Sleeeee/dvh/docs/labs/01_uart/walkthrough.md

# UART lab walkthrough

## Overview

This is a complete walkthrough of the UART lab, that is meant to guide you through every step of the way. You can read through this document to perform the lab, but for educational purposes, it is strongly suggested to use the [instructions](./instructions.md) as a main roadmap, and come back here whenever you feel stuck or need a sanity check.

> By this point, I assume that you have read through the instructions and understood the goal of this lab.

## Walkthrough

### Set up

Before starting the lab, you will need to have a functional [Debugprobe](../../tools/debugprobe.md). If you already performed the [SWD lab](../00_swd), you should already have one and be ready to get started.

We will have to connect the DVH board's UART interface with the corresponding Raspberry Pi Pico to allow them to communicate accordingly :

<div align="center">

| DVH | Pico |
|---|---|
| UART_RX | GP4  |
| UART_TX | GP5  |
| GND | GND  |

</div>

You may need to take a look at the pinout for both the DVH board and the [Raspberry Pi Pico](https://www.raspberrypi.com/documentation/microcontrollers/pico-series.html). As per UART standards, a circuit sends data through its `TX` pin, which is received by the other circuit on its `RX` pin.

<p align="center">
  UART wires
</p>

> Please note that this picture has been shot on the PCB version 0.1 which does not have the dedicated lab selection pins on board.

### Initial access

In order to establish a serial communication over UART, we will start by installing `minicom` :

```bash
sudo apt install minicom
```

> Feel free to choose any other alternative such as PuTTY for example.

You can now power on the Pico and the DVH board, then open the serial port using `minicom` :

```bash
minicom -b 115200 -o -D /dev/ttyACM0
```

Once inside the `minicom` interface, press `[ENTER]` to start receiving the UART shell prompt, as well as the first flag !

<p align="center">
  UART minicom
</p>

> The Raspberry Pi Pico is usually listed as `ttyACM0`, but you can make sure of it by running `ls /dev/tty*`.

### User escalation

By playing around in the terminal, we can see that this looks like a standard shell, maybe even bash ? We can type common commands, such as `ls`, `pwd`, `whoami` to verify if it is truly a Linux shell :

<p align="center">
  UART hello
</p>

Unlike we expected, we are not in a traditional shell environment. The system tells us that the `help` command does exist, let's run that :

<p align="center">
  UART help anonymous
</p>

This looks promising, we have access to built-in commands to log in and list existing users ! Let's see what we can find there :

<p align="center">
  UART list users
</p>

We successfully learned that there are two users on the system, `root` and `monitoring_svc`. However, we cannot directly log in as the root user, so we will have to pivot to `monitoring_svc` first. Unfortunately, it is guarded by a password, and it does not seem like any of the available commands can help us here.

If you are familiar with network equipments and IOT devices, you might remember they regularly use logging over serial connections, to print debug information for example. What we could do here, is to keep listening on our `minicom` session, and reset the power on the DVH board by unplugging it then plugging it back on. Interesting logs will start to appear :

<p align="center">
  UART boot logs
</p>

If we scroll all the way up and take a close look, we will observe that some credentials have actually been leaked ! We can now safely log in as the `monitoring_svc` user and obtain the second flag :

<p align="center">
  UART login
</p>

### Root escalation

We have now gained user privileges, which means we probably have access to new commands now ! Let's type `help` to verify that :

<p align="center">
  UART help user
</p>

We now have access to the `root` command which is noticeably guarded by a password :

<p align="center">
  UART root attempt
</p>

We can also observe that the `user_db` command was unlocked. By reading its usage, it seems pretty interesting to dump the database's contents :

<p align="center">
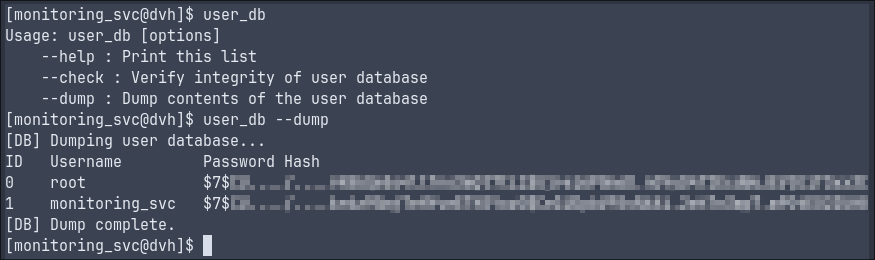
[picture p26: docs/images/uart_database_dump.png]
UART database dump
  
</p>

Unfortunately, we were not able to retrieve plain passwords, but we managed to get the next best thing, which is a password hash for the root user !

> In case you are unfamiliar with the concept, a hash is a one-way encryption method that is commonly used for password authentication. Since a hash can be computed from the original password, you only need to store the hash to verify that it matches the given password's hash.

By inspecting the hash format, we can see it is formatted like a [Linux password](https://man7.org/linux/man-pages/man3/crypt.3.html), which typically looks like this :

```bash
$id$salt$hashed
```

From there, we can identify the hashing function corresponding to ID 7. According to `libxcrypt`, the modern Linux hashing library ([source](https://github.com/besser82/libxcrypt/blob/develop/lib/hashes.conf)), we find that this value corresponds to `scrypt`.

Unfortunately, unlike some obsolete hashing functions like MD5, `scrypt` is considered safe and cannot be broken. However, even if we cannot reverse the hash, nothing is preventing us from brute-forcing it, by computing the hash for common passwords and seeing if any of them matches ! To help us with that, we will swap over to our Linux machine and install John The Ripper, a handy password cracking tool :

```bash
sudo apt update
sudo apt install john
```

John expects hashes to be inside a file, so we can paste our hash into a new `hash.txt` file (you will need to escape the `$` signs by placing a `\` before each of them). We also know the hashing function is `scrypt`. The only thing that is left is to find a wordlist, containing common passwords that will be tested against the hash. The one we will use is one of the most famous wordlists, which comes from a huge data breach from [RockYou](https://github.com/zacheller/rockyou) :

```bash
wget https://raw.githubusercontent.com/zacheller/rockyou/master/rockyou.txt.tar.gz
tar -xzvf rockyou.txt.tar.gz
```

> If you are using a Kali Linux machine, that wordlist is already stored as `/usr/share/wordlists/rockyou.txt`

Now, we can simply pass the hash, the hashing function, and the wordlist to John, and wait for it to return the password :

<p align="center">
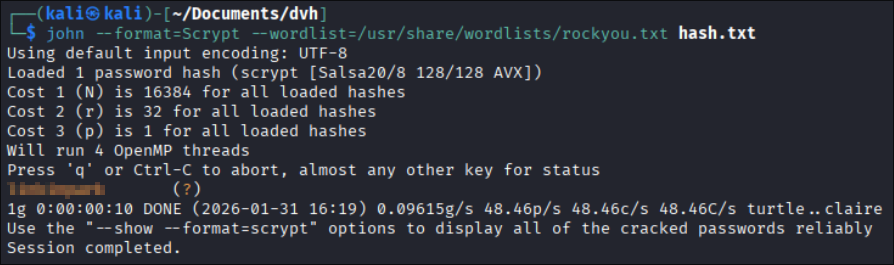
[picture p27: docs/images/uart_john_output.png]
UART John Output
  
</p>

The hash has been successfully brute-forced, and the string in orange is our plaintext password. Let's use that to authenticate as the root user :

<p align="center">
  UART root login
</p>

Congratulations, you have found all flags and successfully completed this lab !
