Sleeeee/dvh/docs/images/logicanalyzer_pulseview_channel.png

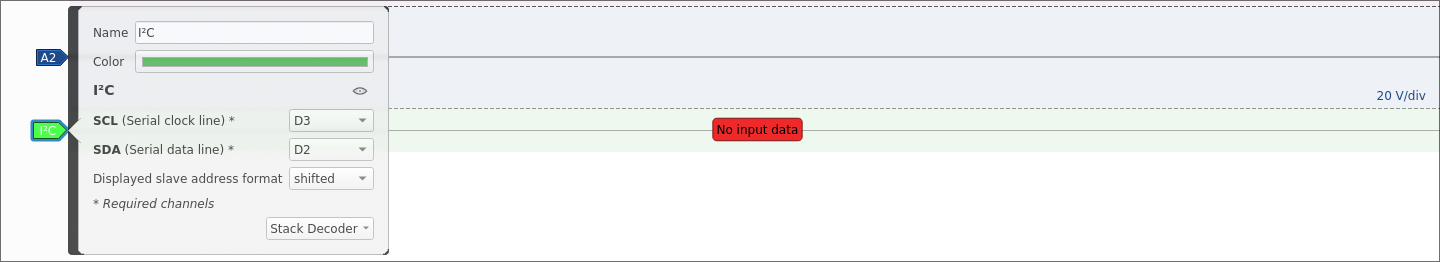
docs/images/logicanalyzer_pulseview_channel.png
