Sleeeee/dvh/docs/images/logicanalyzer_pulseview_decoder.png

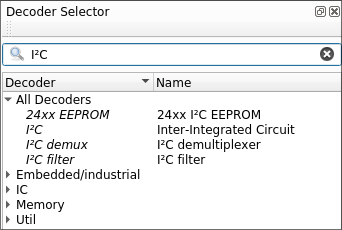
docs/images/logicanalyzer_pulseview_decoder.png
