Sleeeee/dvh/hardware/v1/kicad/v1.kicad_pcb

## KiCad design hardware/v1/kicad/v1.kicad_pcb (2026-05-03)

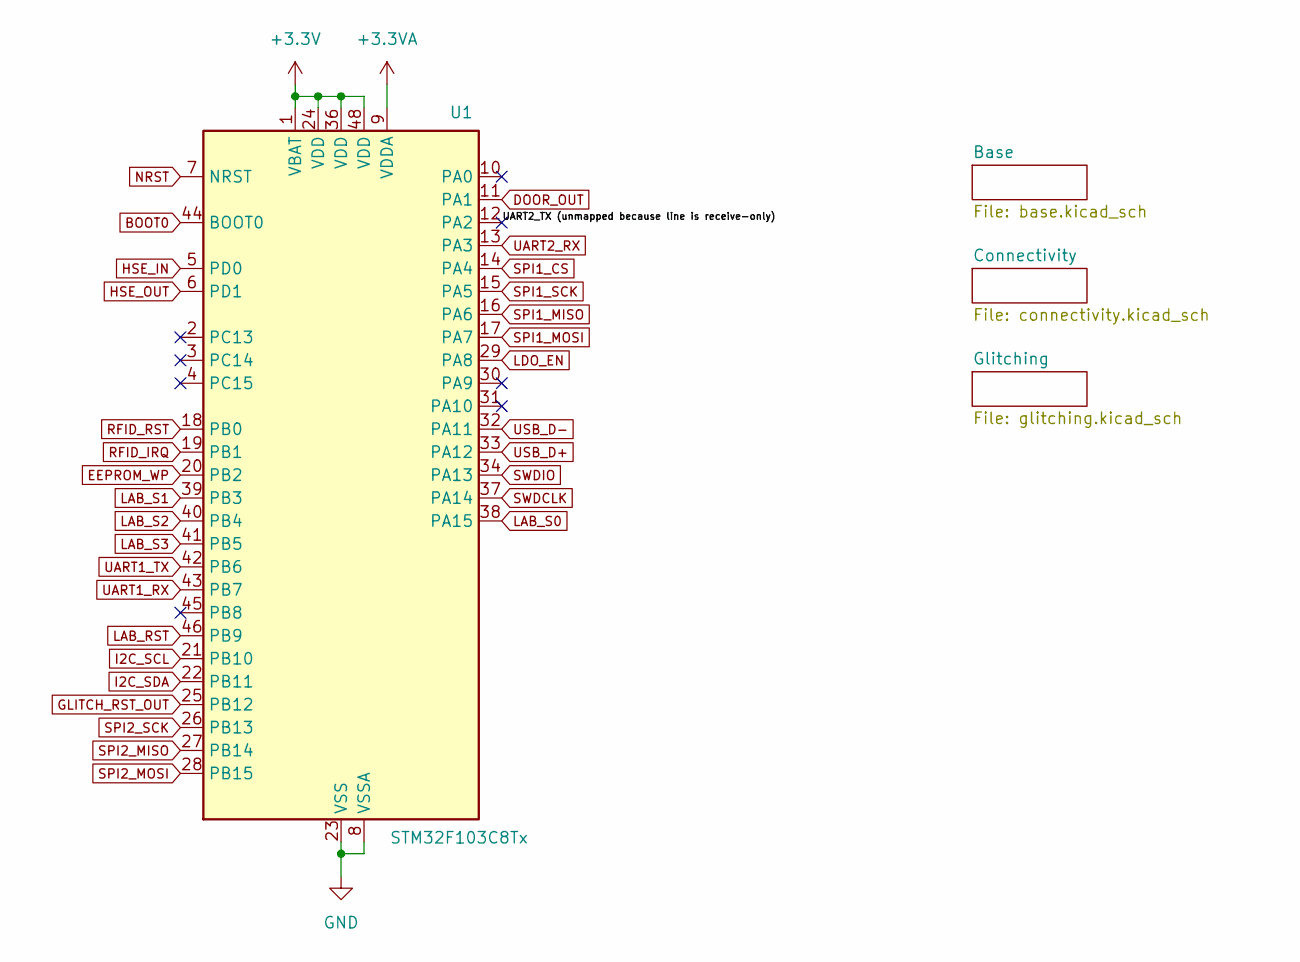
[picture p33: schematic v1.kicad_sch]

Parts:
U1: STM32F103C8Tx; LQFP-48_7x7mm_P0.5mm

Connections:
+3.3V: U1.1 (VBAT), U1.24 (VDD), U1.36 (VDD), U1.48 (VDD); also elsewhere on the board
+3.3VA: U1.9 (VDDA); also elsewhere on the board
/UART2_TX (unmapped because line is receive-only): U1.12 (PA2)
BOOT0: U1.44 (BOOT0); also elsewhere on the board
DOOR_OUT: U1.11 (PA1); also elsewhere on the board
EEPROM_WP: U1.20 (PB2); also elsewhere on the board
GLITCH_RST_OUT: U1.25 (PB12); also elsewhere on the board
GND: U1.8 (VSSA), U1.23 (VSS), U1.35 (VSS), U1.47 (VSS); also elsewhere on the board
HSE_IN: U1.5 (PD0); also elsewhere on the board
HSE_OUT: U1.6 (PD1); also elsewhere on the board
I2C_SCL: U1.21 (PB10); also elsewhere on the board
I2C_SDA: U1.22 (PB11); also elsewhere on the board
LAB_RST: U1.46 (PB9); also elsewhere on the board
LAB_S0: U1.38 (PA15); also elsewhere on the board
LAB_S1: U1.39 (PB3); also elsewhere on the board
LAB_S2: U1.40 (PB4); also elsewhere on the board
LAB_S3: U1.41 (PB5); also elsewhere on the board
LDO_EN: U1.29 (PA8); also elsewhere on the board
NRST: U1.7 (NRST); also elsewhere on the board
RFID_IRQ: U1.19 (PB1); also elsewhere on the board
RFID_RST: U1.18 (PB0); also elsewhere on the board
SPI1_CS: U1.14 (PA4); also elsewhere on the board
SPI1_MISO: U1.16 (PA6); also elsewhere on the board
SPI1_MOSI: U1.17 (PA7); also elsewhere on the board
SPI1_SCK: U1.15 (PA5); also elsewhere on the board
SPI2_MISO: U1.27 (PB14); also elsewhere on the board
SPI2_MOSI: U1.28 (PB15); also elsewhere on the board
SPI2_SCK: U1.26 (PB13); also elsewhere on the board
SWDCLK: U1.37 (PA14); also elsewhere on the board
SWDIO: U1.34 (PA13); also elsewhere on the board
UART1_RX: U1.43 (PB7); also elsewhere on the board
UART1_TX: U1.42 (PB6); also elsewhere on the board
UART2_RX: U1.13 (PA3); also elsewhere on the board
USB_D+: U1.33 (PA12); also elsewhere on the board
USB_D-: U1.32 (PA11); also elsewhere on the board

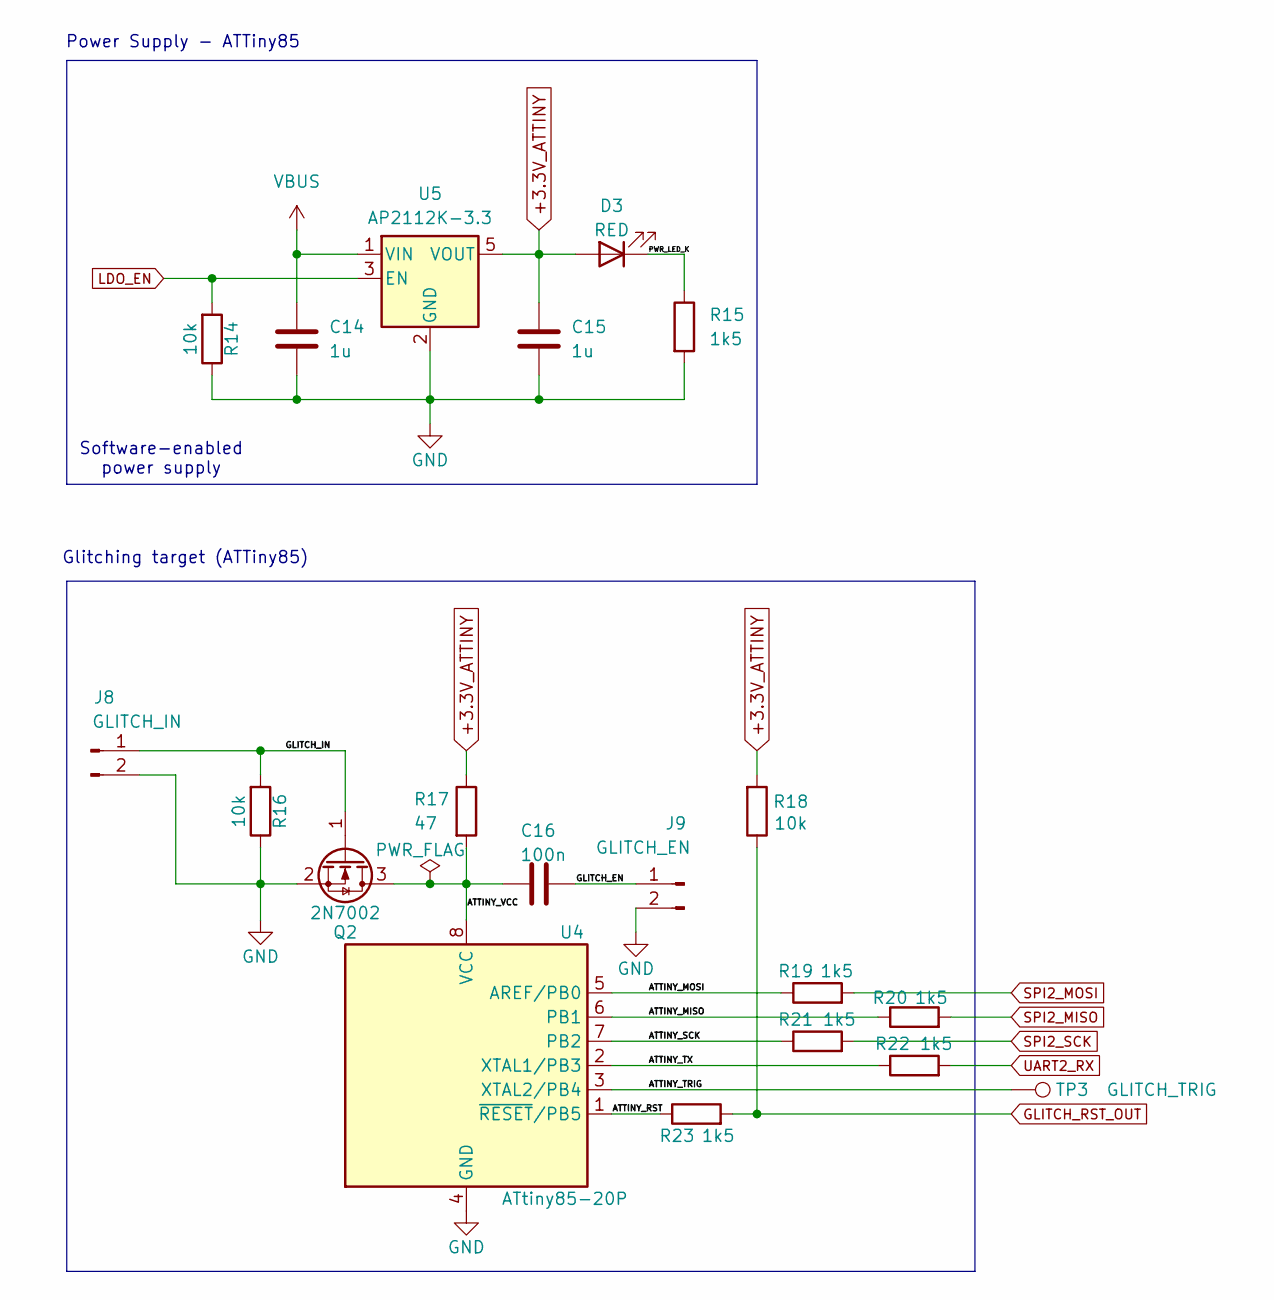
[picture p34: schematic glitching.kicad_sch]

Parts:
C14, C15: 1u; C_0805_2012Metric
C16: 100n; C_0402_1005Metric
D3: RED; LED_0603_1608Metric
J8: GLITCH_IN; PinHeader_1x02_P2.54mm_Vertical
J9: GLITCH_EN; PinHeader_1x02_P2.54mm_Vertical
Q2: 2N7002; SOT-23
R14, R16, R18: 10k; R_0402_1005Metric
R15, R19, R20, R21, R22, R23: 1k5; R_0402_1005Metric
R17: 47; R_1206_3216Metric
TP3: GLITCH_TRIG; TestPoint_THTPad_D2.0mm_Drill1.0mm
U4: ATtiny85-20P; DIP-8_W7.62mm
U5: AP2112K-3.3; SOT-23-5

Connections:
+3.3V_ATTINY: C15.1, D3.2 (A), R17.1, R18.2, U5.5 (VOUT)
/Glitching/ATTINY_MISO: R20.1, U4.6 (PB1)
/Glitching/ATTINY_MOSI: R19.1, U4.5 (AREF/PB0)
/Glitching/ATTINY_RST: R23.1, U4.1 (~RESET/PB5)
/Glitching/ATTINY_SCK: R21.1, U4.7 (PB2)
/Glitching/ATTINY_TRIG: TP3.1, U4.3 (XTAL2/PB4)
/Glitching/ATTINY_TX: R22.1, U4.2 (XTAL1/PB3)
/Glitching/ATTINY_VCC: C16.2, Q2.3 (D), R17.2, U4.8 (VCC)
/Glitching/GLITCH_EN: C16.1, J9.1
/Glitching/GLITCH_IN: J8.1, Q2.1 (G), R16.2
/Glitching/PWR_LED_K: D3.1 (K), R15.1
GLITCH_RST_OUT: R18.1, R23.2; also elsewhere on the board
GND: C14.2, C15.2, J8.2, J9.2, Q2.2 (S), R14.1, R15.2, R16.1, U4.4 (GND), U5.2 (GND); also elsewhere on the board
LDO_EN: R14.2, U5.3 (EN); also elsewhere on the board
SPI2_MISO: R20.2; also elsewhere on the board
SPI2_MOSI: R19.2; also elsewhere on the board
SPI2_SCK: R21.2; also elsewhere on the board
UART2_RX: R22.2; also elsewhere on the board
VBUS: C14.1, U5.1 (VIN); also elsewhere on the board

Notes on the sheet:
Power Supply - ATTiny85
Glitching target (ATTiny85)
Software-enabled power supply

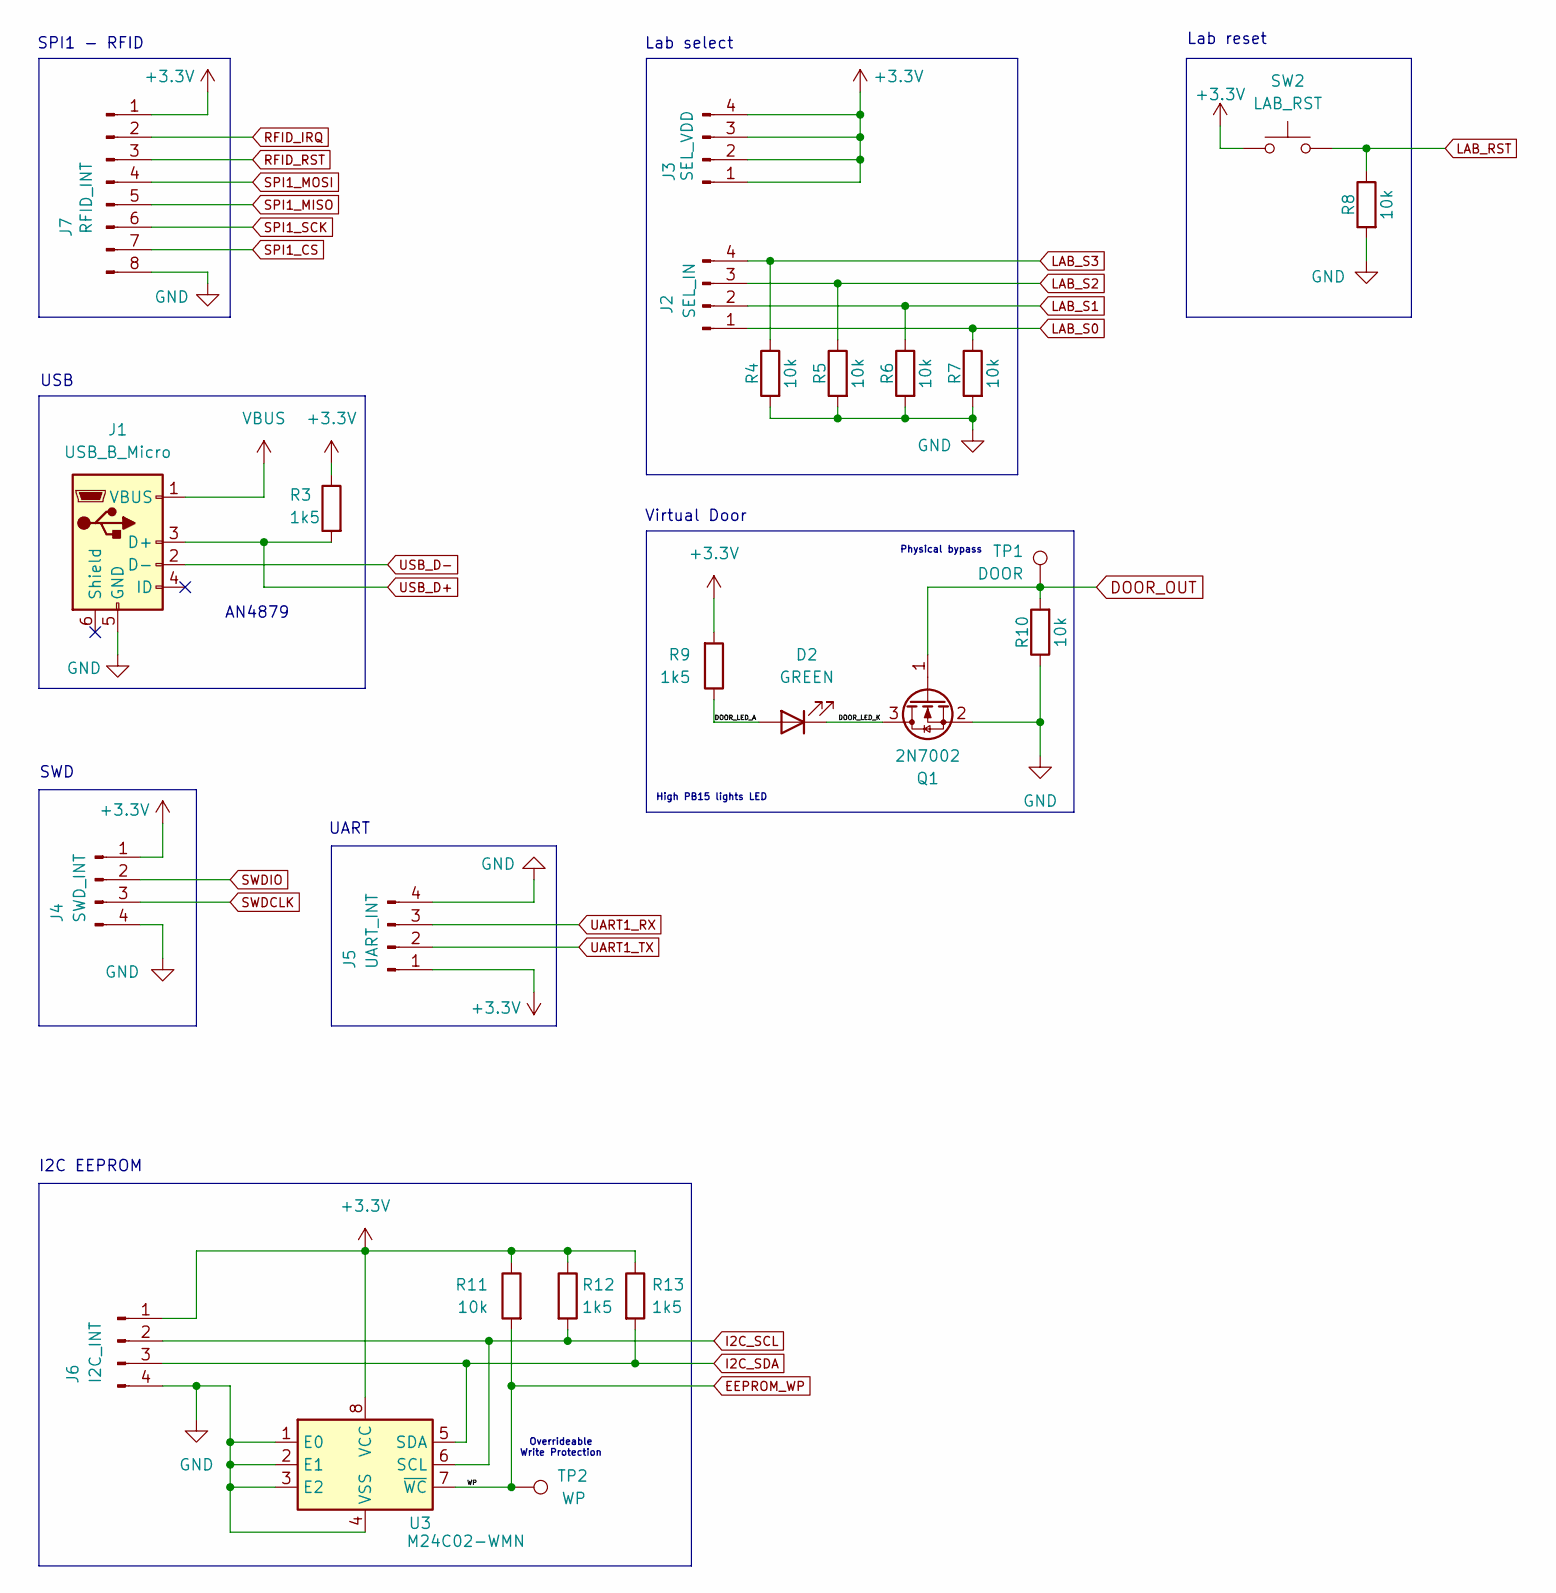
[picture p35: schematic connectivity.kicad_sch]

Parts:
D2: GREEN; LED_0603_1608Metric
J1: USB_B_Micro; USB_Micro-B_Amphenol_10118194-0001LF_Horizontal
J2: SEL_IN; PinHeader_1x04_P2.54mm_Vertical
J3: SEL_VDD; PinHeader_1x04_P2.54mm_Vertical
J4: SWD_INT; PinHeader_1x04_P2.54mm_Vertical
J5: UART_INT; PinHeader_1x04_P2.54mm_Vertical
J6: I2C_INT; PinHeader_1x04_P2.54mm_Vertical
J7: RFID_INT; PinHeader_1x08_P2.54mm_Vertical
Q1: 2N7002; SOT-23
R3, R9, R12, R13: 1k5; R_0402_1005Metric
R4, R5, R6, R7, R8, R10, R11: 10k; R_0402_1005Metric
SW2: LAB_RST; SW_Push_1TS009xxxx-xxxx-xxxx_6x6x5mm
TP1: DOOR; TestPoint_THTPad_D2.0mm_Drill1.0mm
TP2: WP; TestPoint_THTPad_D2.0mm_Drill1.0mm
U3: M24C02-WMN; SOIC-8_3.9x4.9mm_P1.27mm

Connections:
+3.3V: J3.1, J3.2, J3.3, J3.4, J4.1, J5.1, J6.1, J7.1, R3.1, R9.2, R11.1, R12.1, R13.1, SW2.1, U3.8 (VCC); also elsewhere on the board
/Connectivity/DOOR_LED_A: D2.2 (A), R9.1
/Connectivity/DOOR_LED_K: D2.1 (K), Q1.3 (D)
DOOR_OUT: Q1.1 (G), R10.2, TP1.1; also elsewhere on the board
EEPROM_WP: R11.2, TP2.1, U3.7 (~WC); also elsewhere on the board
GND: J1.5 (GND), J4.4, J5.4, J6.4, J7.8, Q1.2 (S), R4.2, R5.2, R6.2, R7.2, R8.2, R10.1, U3.1 (E0), U3.2 (E1), U3.3 (E2), U3.4 (VSS); also elsewhere on the board
I2C_SCL: J6.2, R12.2, U3.6 (SCL); also elsewhere on the board
I2C_SDA: J6.3, R13.2, U3.5 (SDA); also elsewhere on the board
LAB_RST: R8.1, SW2.2; also elsewhere on the board
LAB_S0: J2.1, R7.1; also elsewhere on the board
LAB_S1: J2.2, R6.1; also elsewhere on the board
LAB_S2: J2.3, R5.1; also elsewhere on the board
LAB_S3: J2.4, R4.1; also elsewhere on the board
RFID_IRQ: J7.2; also elsewhere on the board
RFID_RST: J7.3; also elsewhere on the board
SPI1_CS: J7.7; also elsewhere on the board
SPI1_MISO: J7.5; also elsewhere on the board
SPI1_MOSI: J7.4; also elsewhere on the board
SPI1_SCK: J7.6; also elsewhere on the board
SWDCLK: J4.3; also elsewhere on the board
SWDIO: J4.2; also elsewhere on the board
UART1_RX: J5.3; also elsewhere on the board
UART1_TX: J5.2; also elsewhere on the board
USB_D+: J1.3 (D+), R3.2; also elsewhere on the board
USB_D-: J1.2 (D-); also elsewhere on the board
VBUS: J1.1 (VBUS); also elsewhere on the board

Notes on the sheet:
High PB15 lights LED
SPI1 - RFID
USB
Physical bypass
I2C EEPROM
Lab reset
AN4879
UART
SWD
Overrideable Write Protection
Lab select
Virtual Door

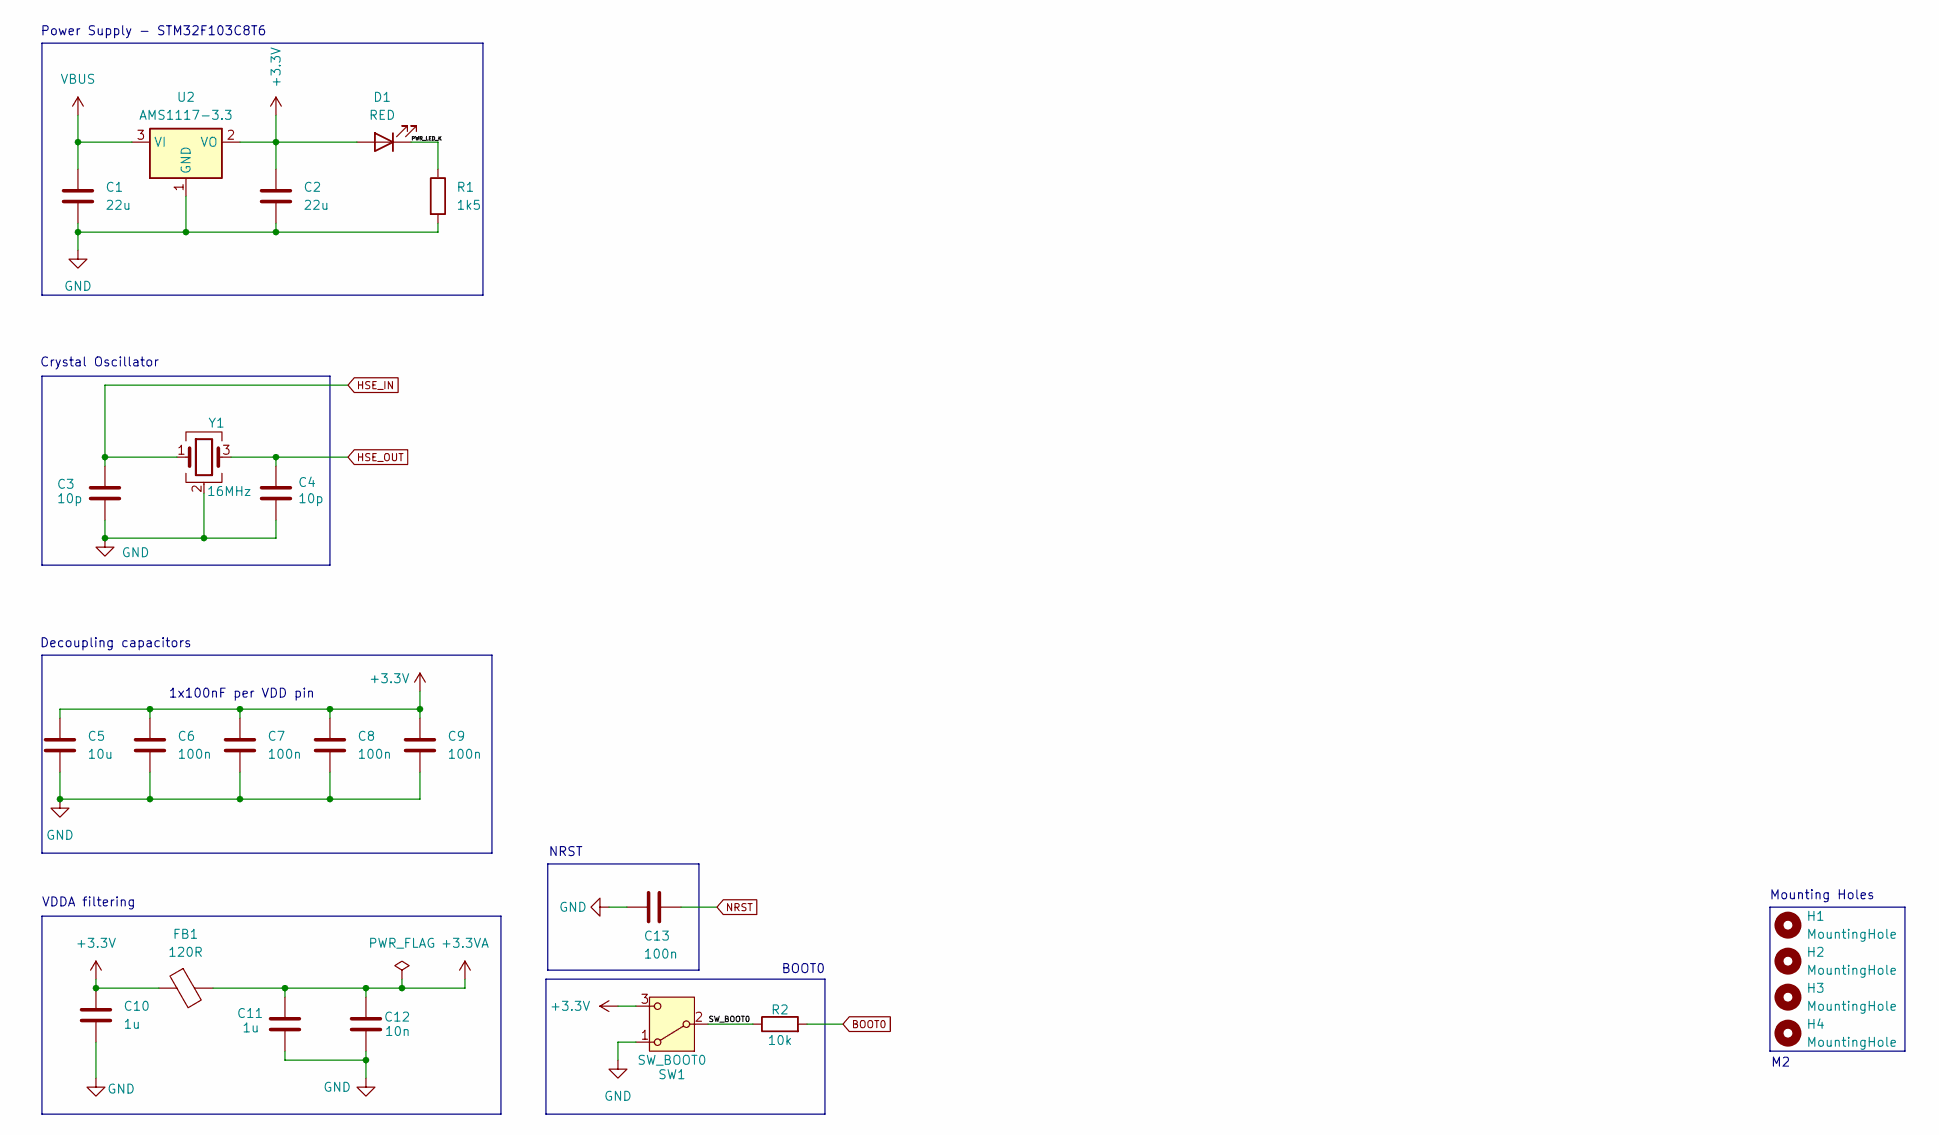
[picture p36: schematic base.kicad_sch]

Parts:
C1, C2: 22u; C_0805_2012Metric
C3, C4: 10p; C_0402_1005Metric
C5: 10u; C_0603_1608Metric
C6, C7, C8, C9, C13: 100n; C_0402_1005Metric
C10, C11: 1u; C_0402_1005Metric
C12: 10n; C_0402_1005Metric
D1: RED; LED_0603_1608Metric
FB1: 120R; L_0603_1608Metric
H1, H2, H3, H4: MountingHole; MountingHole_2.2mm_M2
R1: 1k5; R_0402_1005Metric
R2: 10k; R_0402_1005Metric
SW1: SW_BOOT0; SW_SPDT_CK_JS102011SAQN
U2: AMS1117-3.3; SOT-223-3_TabPin2
Y1: 16MHz; Crystal_SMD_3225-4Pin_3.2x2.5mm

Connections:
+3.3V: C2.1, C5.1, C6.1, C7.1, C8.1, C9.1, C10.1, D1.2 (A), FB1.1, SW1.3 (C), U2.2 (VO); also elsewhere on the board
+3.3VA: C11.1, C12.1, FB1.2; also elsewhere on the board
/Base/PWR_LED_K: D1.1 (K), R1.1
/Base/SW_BOOT0: R2.1, SW1.2 (B)
BOOT0: R2.2; also elsewhere on the board
GND: C1.2, C2.2, C3.2, C4.2, C5.2, C6.2, C7.2, C8.2, C9.2, C10.2, C11.2, C12.2, C13.2, R1.2, SW1.1 (A), U2.1 (GND), Y1.2 (G), Y1.4 (G); also elsewhere on the board
HSE_IN: C3.1, Y1.1; also elsewhere on the board
HSE_OUT: C4.1, Y1.3; also elsewhere on the board
NRST: C13.1; also elsewhere on the board
VBUS: C1.1, U2.3 (VI); also elsewhere on the board

Notes on the sheet:
Decoupling capacitors
NRST
VDDA filtering
Power Supply - STM32F103C8T6
Mounting Holes
Crystal Oscillator
BOOT0
1x100nF per VDD pin

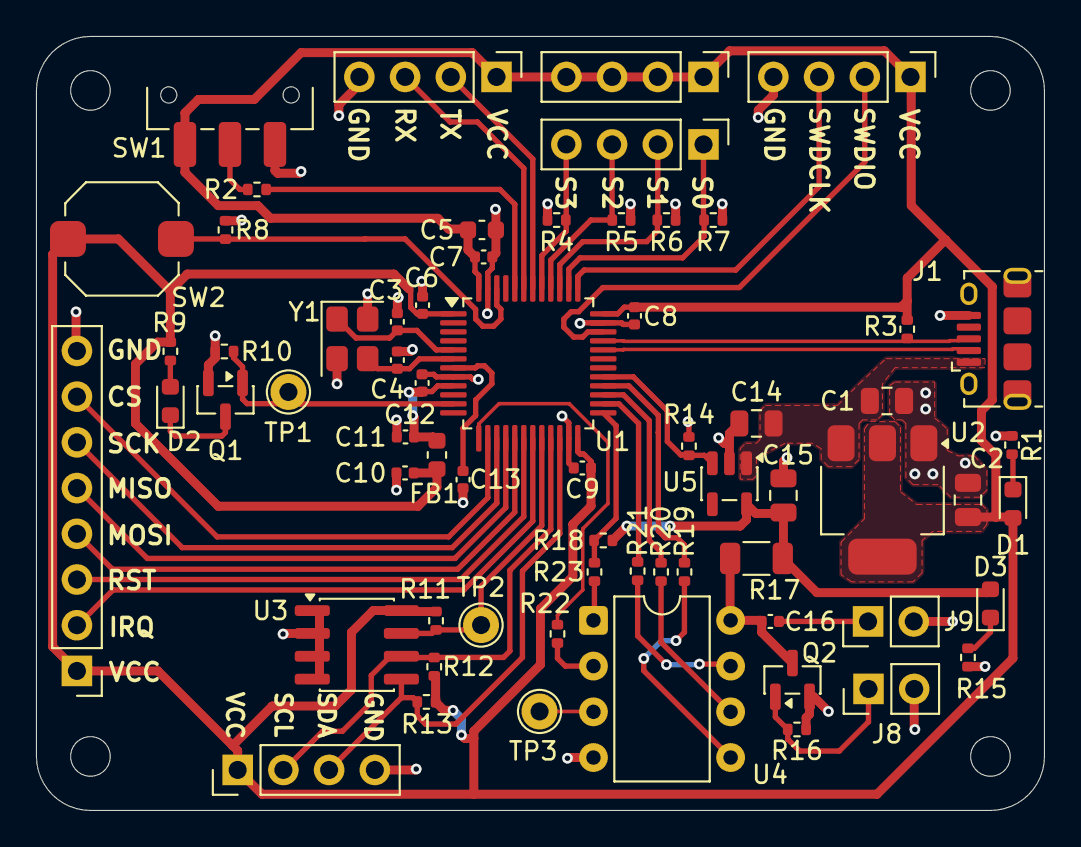
[picture p37: board v1.kicad_pcb from above]

Board: 2 copper layers, 56.0 x 43.0 mm, 69 parts (0 on the bottom side), 50 nets.
