Sleeeee/dvh/hardware/v0/kicad/dvh.kicad_pcb

## KiCad design hardware/v0/kicad/dvh.kicad_pcb (2025-11-27, an earlier design)

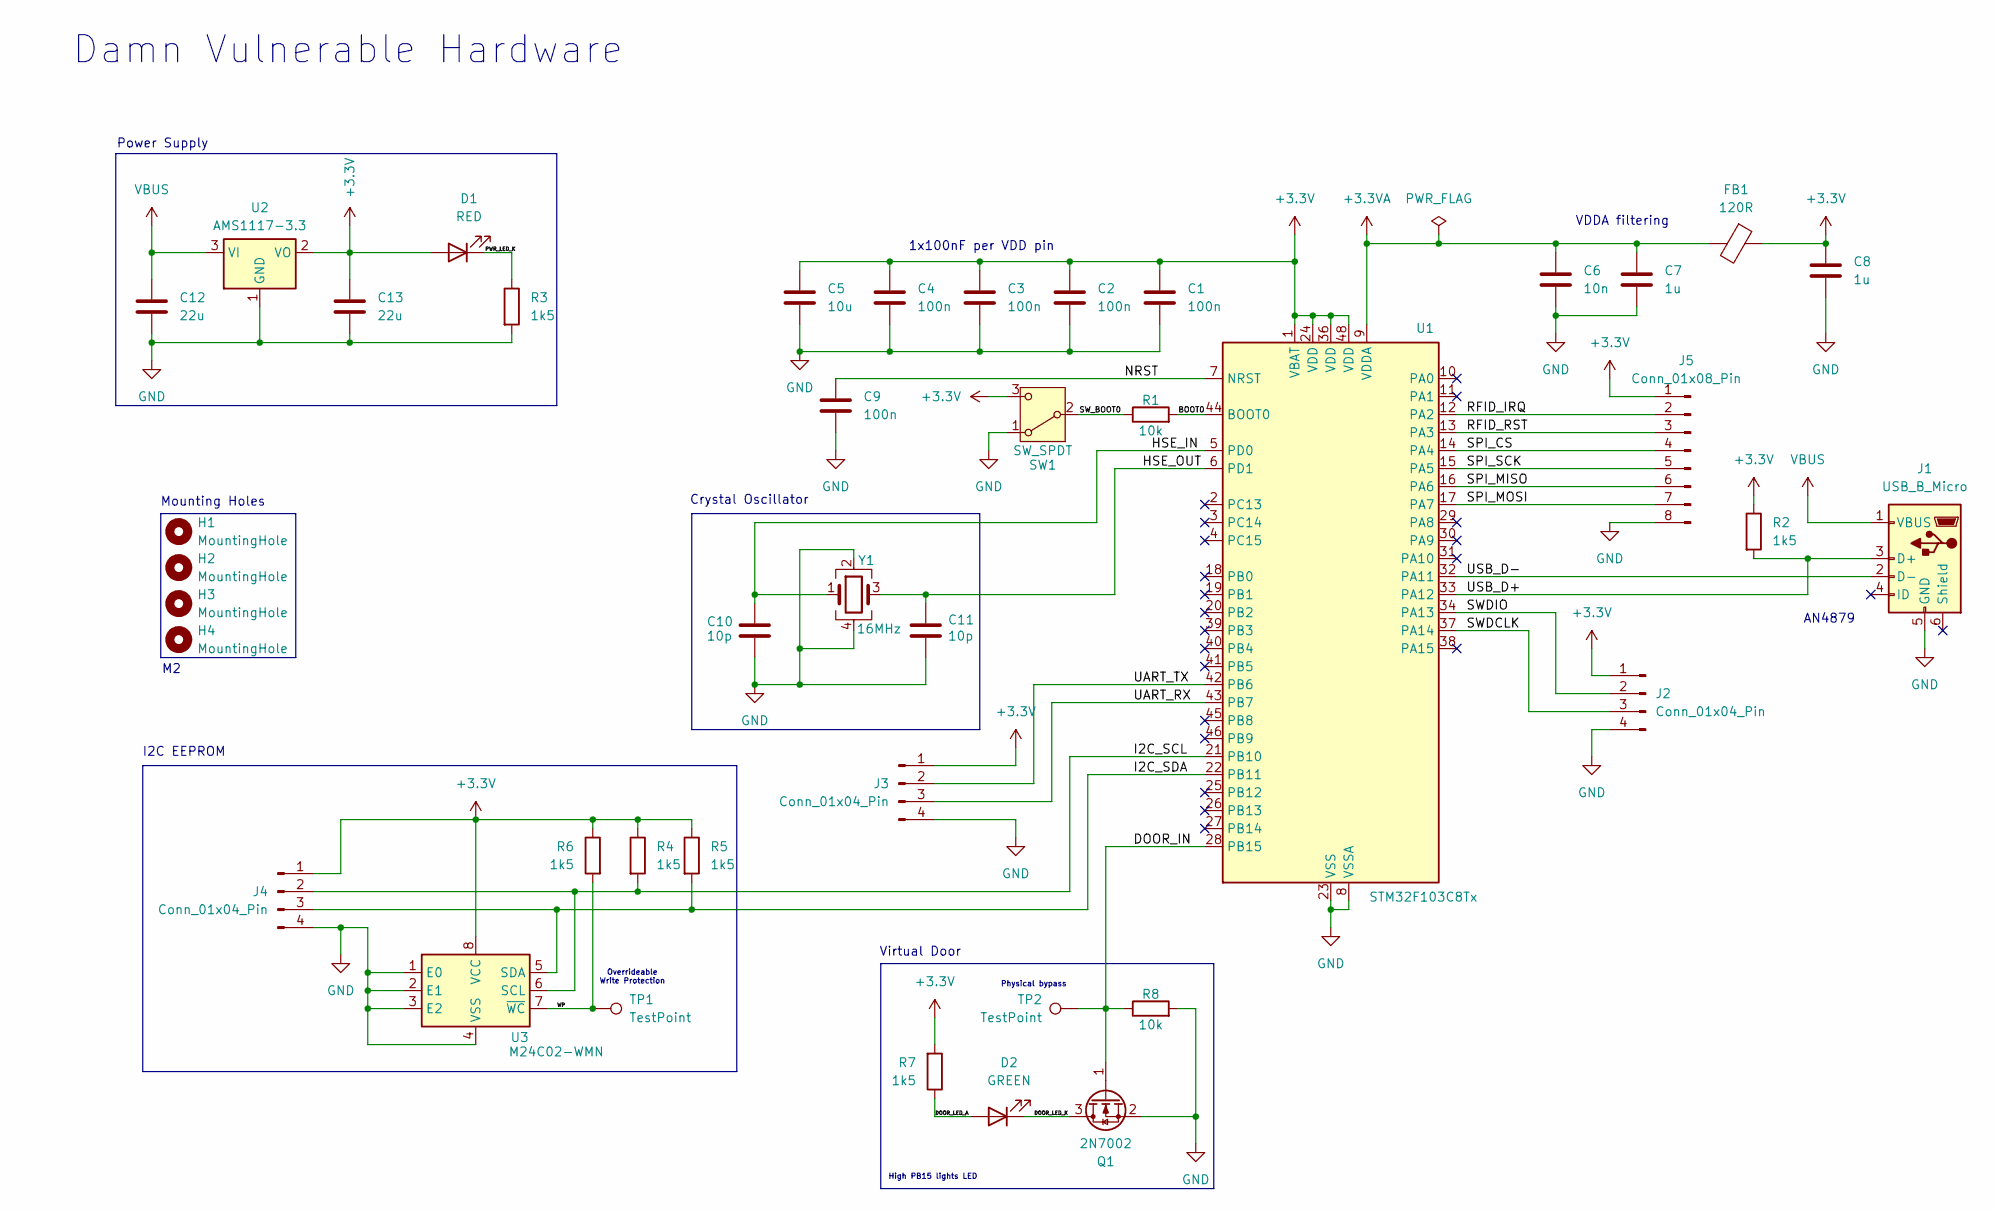
[picture p38: schematic dvh.kicad_sch, Damn Vulnerable Hardware]

Parts:
C1, C2, C3, C4, C9: 100n; C_0402_1005Metric
C5: 10u; C_0603_1608Metric
C6: 10n; C_0402_1005Metric
C7, C8: 1u; C_0402_1005Metric
C10, C11: 10p; C_0402_1005Metric
C12, C13: 22u; C_0805_2012Metric
D1: RED; LED_0603_1608Metric
D2: GREEN; LED_0603_1608Metric
FB1: 120R; L_0603_1608Metric
H1, H2, H3, H4: MountingHole; MountingHole_2.2mm_M2
J1: USB_B_Micro; USB_Micro-B_Amphenol_10118194-0001LF_Horizontal
J2, J3, J4: Conn_01x04_Pin; PinHeader_1x04_P2.54mm_Vertical
J5: Conn_01x08_Pin; PinHeader_1x08_P2.54mm_Vertical
Q1: 2N7002; SOT-23
R1, R8: 10k; R_0402_1005Metric
R2, R3, R4, R5, R6, R7: 1k5; R_0402_1005Metric
SW1: SW_SPDT; SW_SPDT_CK_JS102011SAQN
TP1, TP2: TestPoint; PinSocket_1x01_P2.54mm_Vertical
U1: STM32F103C8Tx; LQFP-48_7x7mm_P0.5mm
U2: AMS1117-3.3; SOT-223-3_TabPin2
U3: M24C02-WMN; SOIC-8_3.9x4.9mm_P1.27mm
Y1: 16MHz; Crystal_SMD_3225-4Pin_3.2x2.5mm

Connections:
+3.3V: C1.1, C2.1, C3.1, C4.1, C5.1, C8.1, C13.1, D1.2 (A), FB1.1, J2.1, J3.1, J4.1, J5.1, R2.1, R4.1, R5.1, R6.1, R7.2, SW1.3 (C), U1.1 (VBAT), U1.24 (VDD), U1.36 (VDD), U1.48 (VDD), U2.2 (VO), U3.8 (VCC); also elsewhere on the board
+3.3VA: C6.1, C7.1, FB1.2, U1.9 (VDDA)
/BOOT0: R1.2, U1.44 (BOOT0)
/DOOR_IN: Q1.1 (G), R8.1, TP2.1, U1.28 (PB15)
/DOOR_LED_A: D2.2 (A), R7.1
/DOOR_LED_K: D2.1 (K), Q1.3 (D)
/HSE_IN: C10.1, U1.5 (PD0), Y1.1
/HSE_OUT: C11.1, U1.6 (PD1), Y1.3
/I2C_SCL: J4.2, R4.2, U1.21 (PB10), U3.6 (SCL)
/I2C_SDA: J4.3, R5.2, U1.22 (PB11), U3.5 (SDA)
/NRST: C9.1, U1.7 (NRST)
/PWR_LED_K: D1.1 (K), R3.1
/RFID_IRQ: J5.2, U1.12 (PA2)
/RFID_RST: J5.3, U1.13 (PA3)
/SPI_CS: J5.4, U1.14 (PA4)
/SPI_MISO: J5.6, U1.16 (PA6)
/SPI_MOSI: J5.7, U1.17 (PA7)
/SPI_SCK: J5.5, U1.15 (PA5)
/SWDCLK: J2.3, U1.37 (PA14)
/SWDIO: J2.2, U1.34 (PA13)
/SW_BOOT0: R1.1, SW1.2 (B); also elsewhere on the board
/UART_RX: J3.3, U1.43 (PB7)
/UART_TX: J3.2, U1.42 (PB6)
/USB_D+: J1.3 (D+), R2.2, U1.33 (PA12)
/USB_D-: J1.2 (D-), U1.32 (PA11)
/WP: R6.2, TP1.1, U3.7 (~WC)
GND: C1.2, C2.2, C3.2, C4.2, C5.2, C6.2, C7.2, C8.2, C9.2, C10.2, C11.2, C12.2, C13.2, J1.5 (GND), J2.4, J3.4, J4.4, J5.8, Q1.2 (S), R3.2, R8.2, SW1.1 (A), U1.8 (VSSA), U1.23 (VSS), U1.35 (VSS), U1.47 (VSS), U2.1 (GND), U3.1 (E0), U3.2 (E1), U3.3 (E2), U3.4 (VSS), Y1.2, Y1.4; also elsewhere on the board
VBUS: C12.1, J1.1 (VBUS), U2.3 (VI)

Notes on the sheet:
Overrideable Write Protection
Power Supply
Mounting Holes
Physical bypass
VDDA filtering
High PB15 lights LED
Crystal Oscillator
Damn Vulnerable Hardware
Virtual Door
I2C EEPROM
AN4879
1x100nF per VDD pin

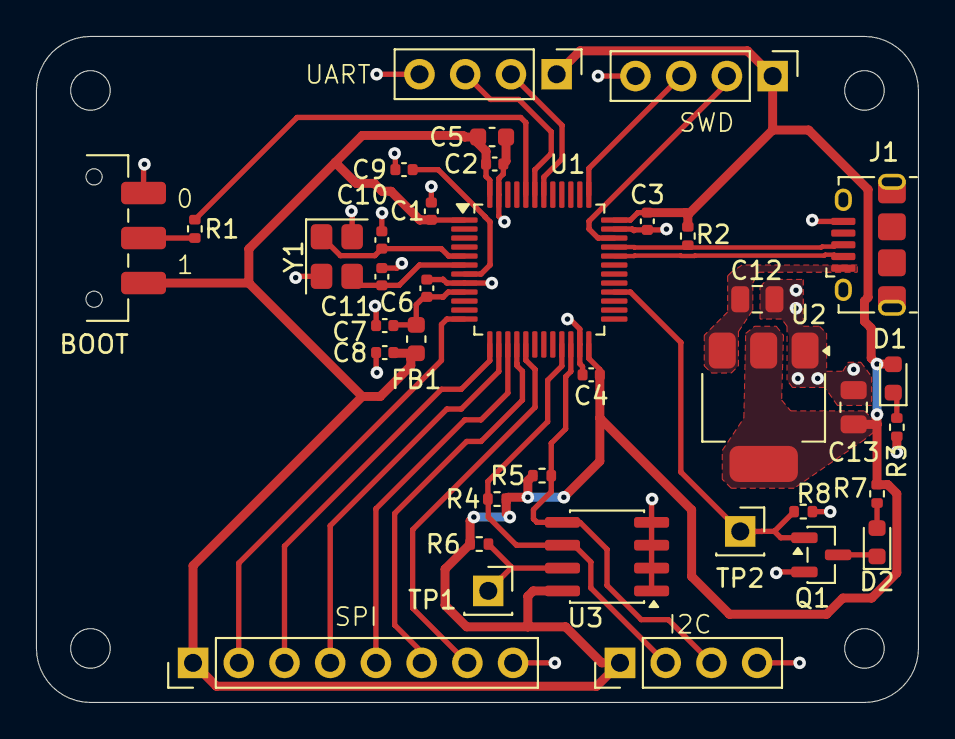
[picture p39: board dvh.kicad_pcb from above]

Board: 2 copper layers, 49.0 x 37.0 mm, 41 parts (0 on the bottom side), 28 nets.

Other parts of the board:
BOOT: SW_SPDT; SW_SPDT_CK_JS102011SAQN

Their connections:
+3.3V: BOOT.3 (C); also elsewhere on the board
/SW_BOOT0: BOOT.2 (B); also elsewhere on the board
GND: BOOT.1 (A); also elsewhere on the board
