Sleeeee/dvh/firmware/Core/Inc/main.h

#define HSE_IN_Pin GPIO_PIN_0
#define HSE_IN_GPIO_Port GPIOD
#define HSE_OUT_Pin GPIO_PIN_1
#define HSE_OUT_GPIO_Port GPIOD
#define DOOR_OUT_Pin GPIO_PIN_1
#define DOOR_OUT_GPIO_Port GPIOA
#define SCREEN_BLK_Pin GPIO_PIN_4
#define SCREEN_BLK_GPIO_Port GPIOA
#define SPI1_SCK_Pin GPIO_PIN_5
#define SPI1_SCK_GPIO_Port GPIOA
#define SPI1_MOSI_Pin GPIO_PIN_7
#define SPI1_MOSI_GPIO_Port GPIOA
#define SCREEN_RES_Pin GPIO_PIN_0
#define SCREEN_RES_GPIO_Port GPIOB
#define SCREEN_DC_Pin GPIO_PIN_1
#define SCREEN_DC_GPIO_Port GPIOB
#define EEPROM_WP_Pin GPIO_PIN_2
#define EEPROM_WP_GPIO_Port GPIOB
#define I2C_SCL_Pin GPIO_PIN_10
#define I2C_SCL_GPIO_Port GPIOB
#define I2C_SDA_Pin GPIO_PIN_11
#define I2C_SDA_GPIO_Port GPIOB
#define ATTINY_RST_Pin GPIO_PIN_12
#define ATTINY_RST_GPIO_Port GPIOB
#define LDO_EN_Pin GPIO_PIN_8
#define LDO_EN_GPIO_Port GPIOA
#define SWDIO_Pin GPIO_PIN_13
#define SWDIO_GPIO_Port GPIOA
#define SWDCLK_Pin GPIO_PIN_14
#define SWDCLK_GPIO_Port GPIOA
#define LAB_S0_Pin GPIO_PIN_15
#define LAB_S0_GPIO_Port GPIOA
#define LAB_S1_Pin GPIO_PIN_3
#define LAB_S1_GPIO_Port GPIOB
#define LAB_S2_Pin GPIO_PIN_4
#define LAB_S2_GPIO_Port GPIOB
#define LAB_S3_Pin GPIO_PIN_5
#define LAB_S3_GPIO_Port GPIOB
#define UART_TX_Pin GPIO_PIN_6
#define UART_TX_GPIO_Port GPIOB
#define UART_RX_Pin GPIO_PIN_7
#define UART_RX_GPIO_Port GPIOB
#define LAB_RST_Pin GPIO_PIN_9
#define LAB_RST_GPIO_Port GPIOB
