Sleeeee/dvh/firmware/dvh/labs/01_uart/src/lab_uart_data.c

#include "lab_uart_data.h"
#include "lab_uart_commands.h"
#include <stddef.h>

// DVH{1ns1d3_th3_syst3m_be8811624e}
const unsigned char LAB_UART_FLAG_ONE[] = {0x2e, 0x23, 0x3b, 0x0f, 0x58, 0x00, 0x19, 0x44, 0x17, 0x47, 0x36, 0x1a, 0x02, 0x46, 0x2c, 0x07, 0x10, 0x1d, 0x1e, 0x46, 0x1e, 0x2b, 0x0b, 0x0b, 0x52, 0x4d, 0x42, 0x45, 0x5f, 0x5c, 0x5e, 0x10, 0x0e};
const int LAB_UART_FLAG_ONE_LEN = sizeof(LAB_UART_FLAG_ONE);

// DVH{h0w_d1d_y0u_g3t_h3r3_e322687e2e}
const unsigned char LAB_UART_FLAG_TWO[] = {0x2e, 0x23, 0x3b, 0x0f, 0x01, 0x5e, 0x1d, 0x2a, 0x17, 0x45, 0x0d, 0x31, 0x13, 0x45, 0x06, 0x2b, 0x0e, 0x5d, 0x1e, 0x2a, 0x1b, 0x47, 0x1b, 0x5d, 0x35, 0x10, 0x40, 0x46, 0x5b, 0x58, 0x52, 0x42, 0x16, 0x46, 0x0c, 0x13};
const int LAB_UART_FLAG_TWO_LEN = sizeof(LAB_UART_FLAG_TWO);

// DVH{h4v3_y0u_m3t_my_fr13nd_j0hn_9ef271f76e}
const unsigned char LAB_UART_FLAG_THREE[] = {0x2e, 0x23, 0x3b, 0x0f, 0x01, 0x5a, 0x1c, 0x46, 0x2c, 0x0d, 0x59, 0x1b, 0x35, 0x18, 0x40, 0x00, 0x36, 0x03, 0x13, 0x2a, 0x15, 0x06, 0x58, 0x5d, 0x04, 0x11, 0x2c, 0x1e, 0x59, 0x06, 0x04, 0x2a, 0x4a, 0x11, 0x0f, 0x5c, 0x5d, 0x44, 0x15, 0x43, 0x5f, 0x0b, 0x17};
const int LAB_UART_FLAG_THREE_LEN = sizeof(LAB_UART_FLAG_THREE);

const char LAB_UART_USER_USERNAME[] = "monitoring_svc";

// u4rt_1s_pr3tty_v3rb0s3
const unsigned char LAB_UART_USER_PASSWORD[] = {0x1f, 0x41, 0x01, 0x00, 0x36, 0x5f, 0x19, 0x2a, 0x03, 0x06, 0x5a, 0x1a, 0x1e, 0x0c, 0x2c, 0x02, 0x5a, 0x1c, 0x08, 0x45, 0x00, 0x47};
const int LAB_UART_USER_PASSWORD_LEN = sizeof(LAB_UART_USER_PASSWORD);

// $7$CU..../....6rdz9SmjTeHYveETHSYxz0$Ce1UDpbVF0vNkXi.2ehTn3mp7.mP0tEO2ZUHwUNVXK8
const unsigned char LAB_UART_USER_HASH[] = {0x4e, 0x42, 0x57, 0x37, 0x3c, 0x40, 0x44, 0x5b, 0x5d, 0x5b, 0x47, 0x40, 0x44, 0x5b, 0x45, 0x06, 0x0d, 0x14, 0x53, 0x26, 0x1e, 0x1e, 0x3d, 0x0b, 0x22, 0x2c, 0x05, 0x11, 0x2c, 0x3a, 0x22, 0x26, 0x2a, 0x0c, 0x13, 0x5e, 0x4e, 0x36, 0x16, 0x45, 0x3c, 0x2a, 0x1a, 0x17, 0x25, 0x32, 0x59, 0x18, 0x24, 0x1e, 0x2b, 0x1d, 0x47, 0x5c, 0x0f, 0x1d, 0x27, 0x1a, 0x5a, 0x03, 0x1a, 0x42, 0x5d, 0x19, 0x39, 0x5e, 0x1e, 0x30, 0x3c, 0x46, 0x33, 0x3b, 0x22, 0x02, 0x26, 0x3a, 0x3f, 0x36, 0x21, 0x4d};
const int LAB_UART_USER_HASH_LEN = sizeof(LAB_UART_USER_HASH);

const char LAB_UART_ROOT_USERNAME[] = "root";

// linkinpark
const unsigned char LAB_UART_ROOT_PASSWORD[] = {0x06, 0x1c, 0x1d, 0x1f, 0x00, 0x00, 0x1a, 0x14, 0x01, 0x1f};
const int LAB_UART_ROOT_PASSWORD_LEN = sizeof(LAB_UART_ROOT_PASSWORD);

// $7$CU..../....rK8bQeEo4llTno3mQt7tL1$Ujrei6P0msD.n0YyD47IEcdWoJEVjEiT3xx3FKi0aqC
const unsigned char LAB_UART_ROOT_HASH[] = {0x4e, 0x42, 0x57, 0x37, 0x3c, 0x40, 0x44, 0x5b, 0x5d, 0x5b, 0x47, 0x40, 0x44, 0x5b, 0x01, 0x3f, 0x51, 0x0c, 0x3b, 0x10, 0x36, 0x1b, 0x5d, 0x02, 0x06, 0x21, 0x1d, 0x1b, 0x5a, 0x03, 0x3b, 0x01, 0x44, 0x00, 0x25, 0x5f, 0x4e, 0x20, 0x19, 0x06, 0x0c, 0x07, 0x5c, 0x25, 0x43, 0x19, 0x1a, 0x2a, 0x44, 0x1b, 0x43, 0x2d, 0x10, 0x2a, 0x5e, 0x42, 0x3a, 0x31, 0x0a, 0x0a, 0x3d, 0x1a, 0x39, 0x31, 0x3f, 0x04, 0x2f, 0x1c, 0x27, 0x47, 0x11, 0x16, 0x59, 0x33, 0x38, 0x1d, 0x59, 0x0f, 0x1b, 0x36};
const int LAB_UART_ROOT_HASH_LEN = sizeof(LAB_UART_ROOT_HASH);

const Utils_Shell_Command LAB_UART_COMMANDS_ANONYMOUS[] = {
  {"echo", Utils_Shell_Cmd_Echo, "Echo text back to the terminal"},
  {"clear", Utils_Shell_Cmd_Clear, "Clear the terminal"},
  {"get_users", Lab_UART_Cmd_GetUsers, "Fetch the list of existing users"},
  {"login", Lab_UART_Cmd_Login, "Log in as an existing user"},
  {NULL, NULL, NULL}
};

const Utils_Shell_Command LAB_UART_COMMANDS_USER[] = {
  {"echo", Utils_Shell_Cmd_Echo, "Echo text back to the terminal"},
  {"clear", Utils_Shell_Cmd_Clear, "Clear the terminal"},
  {"get_users", Lab_UART_Cmd_GetUsers, "Fetch the list of existing users"},
  {"user_db", Lab_UART_Cmd_UserDb, "Manage the internal user database"},
  {"root", Lab_UART_Cmd_Root, "Log in as root"},
  {NULL, NULL, NULL}
};

const Utils_Shell_Command LAB_UART_COMMANDS_ROOT[] = {
  {"echo", Utils_Shell_Cmd_Echo, "Echo text back to the terminal"},
  {"clear", Utils_Shell_Cmd_Clear, "Clear the terminal"},
  {"get_users", Lab_UART_Cmd_GetUsers, "Fetch the list of existing users"},
  {"user_db", Lab_UART_Cmd_UserDb, "Manage the internal user database"},
  {"reboot", Utils_Shell_Cmd_Reboot, "Reboot the shell"},
  {NULL, NULL, NULL}
};
