Sleeeee/dvh/firmware/dvh/labs/02_i2c/src/lab_i2c_data.c

#include "lab_i2c_data.h"
#include "lab_i2c_commands.h"
#include <stddef.h>

// DVH{w1r3_wh1sp3r3r_a1155044c5}
const unsigned char LAB_I2C_FLAG_ONE[] = {0x2e, 0x23, 0x3b, 0x0f, 0x1e, 0x5f, 0x18, 0x46, 0x2c, 0x03, 0x01, 0x5f, 0x19, 0x05, 0x40, 0x06, 0x5a, 0x1c, 0x35, 0x14, 0x42, 0x45, 0x5c, 0x5b, 0x5a, 0x41, 0x47, 0x17, 0x5c, 0x13};
const int LAB_I2C_FLAG_ONE_LEN = sizeof(LAB_I2C_FLAG_ONE);

// DVH{st0r4g3_f0r3ns1cs_a8e865f148}
const unsigned char LAB_I2C_FLAG_TWO[] = {0x2e, 0x23, 0x3b, 0x0f, 0x1a, 0x1a, 0x5a, 0x07, 0x47, 0x13, 0x5a, 0x31, 0x0c, 0x45, 0x01, 0x47, 0x07, 0x1d, 0x5b, 0x16, 0x00, 0x2b, 0x08, 0x56, 0x0f, 0x4d, 0x45, 0x41, 0x0f, 0x5f, 0x5e, 0x4d, 0x0e};
const int LAB_I2C_FLAG_TWO_LEN = sizeof(LAB_I2C_FLAG_TWO);

// DVH{c3rt1f13d_c0ff33_l0v3r_8f4c8ebd90}
const unsigned char LAB_I2C_FLAG_THREE[] = {0x2e, 0x23, 0x3b, 0x0f, 0x0a, 0x5d, 0x18, 0x01, 0x42, 0x12, 0x58, 0x5d, 0x0e, 0x2a, 0x10, 0x44, 0x0f, 0x08, 0x59, 0x46, 0x2c, 0x18, 0x59, 0x18, 0x59, 0x07, 0x2c, 0x4c, 0x0f, 0x5a, 0x09, 0x4d, 0x16, 0x16, 0x0d, 0x57, 0x5a, 0x08};
const int LAB_I2C_FLAG_THREE_LEN = sizeof(LAB_I2C_FLAG_THREE);

// burn3d_1n_th3_r0m
const unsigned char LAB_I2C_USER_PASSWORD[] = {0x08, 0x00, 0x01, 0x1a, 0x5a, 0x0a, 0x35, 0x44, 0x1d, 0x2b, 0x1d, 0x06, 0x59, 0x2a, 0x01, 0x44, 0x04};
const int LAB_I2C_USER_PASSWORD_LEN = sizeof(LAB_I2C_USER_PASSWORD);

// CONFIG_NOTE: For root access, write 2-byte magic sequence to EEPROM addr 0x30 | [flag two placeholder]
const unsigned char LAB_I2C_CONFIG_NOTE[] = {0x29, 0x3a, 0x3d, 0x32, 0x20, 0x29, 0x35, 0x3b, 0x3c, 0x20, 0x2c, 0x54, 0x4a, 0x33, 0x1c, 0x06, 0x49, 0x1c, 0x05, 0x1a, 0x07, 0x54, 0x08, 0x0d, 0x09, 0x10, 0x00, 0x07, 0x45, 0x4e, 0x1d, 0x07, 0x1a, 0x00, 0x0c, 0x4e, 0x58, 0x58, 0x11, 0x0d, 0x1d, 0x0b, 0x4a, 0x18, 0x12, 0x13, 0x00, 0x0d, 0x4a, 0x06, 0x16, 0x05, 0x1c, 0x0b, 0x04, 0x16, 0x16, 0x54, 0x1d, 0x01, 0x4a, 0x30, 0x36, 0x24, 0x3b, 0x21, 0x27, 0x55, 0x12, 0x10, 0x0d, 0x1c, 0x4a, 0x45, 0x0b, 0x47, 0x59, 0x4e, 0x16, 0x55};
const int LAB_I2C_CONFIG_NOTE_LEN = sizeof(LAB_I2C_CONFIG_NOTE);

const Utils_Shell_Command LAB_I2C_COMMANDS_ANONYMOUS[] = {
  {"echo", Utils_Shell_Cmd_Echo, "Echo text back to the terminal"},
  {"clear", Utils_Shell_Cmd_Clear, "Clear the terminal"},
  {"login", Lab_I2C_Cmd_Login, "Log in as a user"},
  {NULL, NULL, NULL}
};

const Utils_Shell_Command LAB_I2C_COMMANDS_USER[] = {
  {"echo", Utils_Shell_Cmd_Echo, "Echo text back to the terminal"},
  {"clear", Utils_Shell_Cmd_Clear, "Clear the terminal"},
  {"coffee", Lab_I2C_Cmd_Coffee, "Interact with the coffee knowledge base"},
  {"root", Lab_I2C_Cmd_Root, "Log in as root"},
  {NULL, NULL, NULL}
};

const Utils_Shell_Command LAB_I2C_COMMANDS_ROOT[] = {
  {"echo", Utils_Shell_Cmd_Echo, "Echo text back to the terminal"},
  {"clear", Utils_Shell_Cmd_Clear, "Clear the terminal"},
  {"reboot", Utils_Shell_Cmd_Reboot, "Reboot the shell"},
  {NULL, NULL, NULL}
};

const char* LAB_I2C_COFFEE_FACTS[] = {
  "\r\nCoffee fact 1 : Coffee Consumption Basics\r\nThe average person consumes the equivalent of six coffee plants each year.\r\nMost coffee drinkers enjoy two to three cups daily, though habits can highly vary.\r\n",
  "\r\nCoffee fact 2 : French for 'coffee' is 'café'\r\nIt can even be spelled with two hexadecimal bytes as 0xcafe !\r\nThat makes up for pretty neat magic bytes to sneak in a CTF for example !\r\n",
  "\r\nCoffee fact 3 : Coffee in Space\r\nAstronauts enjoy coffee too, but brewing it in microgravity is challenging.\r\nToday, the ISSpresso machine allows them to prepare espresso using specially designed pods.\r\n",
  NULL
};
