Sleeeee/dvh/firmware/dvh/labs/03_glitch/include/lab_glitch_data.h

#ifndef LAB_GLITCH_DATA_H
#define LAB_GLITCH_DATA_H

extern const unsigned char LAB_GLITCH_FLAG_ONE[];
extern const int LAB_GLITCH_FLAG_ONE_LEN;

extern const unsigned char LAB_GLITCH_FLAG_TWO[];
extern const int LAB_GLITCH_FLAG_TWO_LEN;

#endif
