Sleeeee/dvh/firmware/dvh/labs/03_glitch/src/lab_glitch_data.c

#include "lab_glitch_data.h"

// DVH{br0wn3d_0ut_50bd763c0d}
const unsigned char LAB_GLITCH_FLAG_ONE[] = {0x2e, 0x23, 0x3b, 0x0f, 0x0b, 0x1c, 0x5a, 0x02, 0x1d, 0x47, 0x0d, 0x31, 0x5a, 0x00, 0x07, 0x2b, 0x5c, 0x5e, 0x08, 0x11, 0x44, 0x42, 0x5a, 0x0d, 0x5a, 0x11, 0x0e};
const int LAB_GLITCH_FLAG_ONE_LEN = sizeof(LAB_GLITCH_FLAG_ONE);

// DVH{gl1tch_m4st3r_335b04723e}
const unsigned char LAB_GLITCH_FLAG_TWO[] = {0x2e, 0x23, 0x3b, 0x0f, 0x0e, 0x02, 0x5b, 0x01, 0x10, 0x1c, 0x36, 0x03, 0x5e, 0x06, 0x07, 0x47, 0x1b, 0x31, 0x59, 0x46, 0x46, 0x16, 0x59, 0x5a, 0x5d, 0x47, 0x40, 0x11, 0x14};
const int LAB_GLITCH_FLAG_TWO_LEN = sizeof(LAB_GLITCH_FLAG_TWO);
