Sleeeee/dvh/firmware/dvh/labs/01_uart/include/lab_uart_data.h

#ifndef LAB_UART_DATA_H
#define LAB_UART_DATA_H

#include "utils_shell.h"

extern const unsigned char LAB_UART_FLAG_ONE[];
extern const int LAB_UART_FLAG_ONE_LEN;

extern const unsigned char LAB_UART_FLAG_TWO[];
extern const int LAB_UART_FLAG_TWO_LEN;

extern const unsigned char LAB_UART_FLAG_THREE[];
extern const int LAB_UART_FLAG_THREE_LEN;

extern const char LAB_UART_USER_USERNAME[];
extern const unsigned char LAB_UART_USER_PASSWORD[];
extern const int LAB_UART_USER_PASSWORD_LEN;
extern const unsigned char LAB_UART_USER_HASH[];
extern const int LAB_UART_USER_HASH_LEN;

extern const char LAB_UART_ROOT_USERNAME[];
extern const unsigned char LAB_UART_ROOT_PASSWORD[];
extern const int LAB_UART_ROOT_PASSWORD_LEN;
extern const unsigned char LAB_UART_ROOT_HASH[];
extern const int LAB_UART_ROOT_HASH_LEN;

extern const Utils_Shell_Command LAB_UART_COMMANDS_ANONYMOUS[];
extern const Utils_Shell_Command LAB_UART_COMMANDS_USER[];
extern const Utils_Shell_Command LAB_UART_COMMANDS_ROOT[];

#endif
