Sleeeee/dvh/firmware/tests/unit/src/test_lab_uart_commands.c

#include "../lib/unity.h"
#include "../../../dvh/labs/01_uart/src/lab_uart_commands.c"
#include "../../../dvh/labs/01_uart/src/lab_uart_data.c"
#include "../../../dvh/shared/src/utils_secrets.c"
#include "../mocks/mock_utils_uart.c"
#include "../mocks/mock_utils_screen.c"
#include "stm32f1xx_hal.h"
#include <string.h>

// Stubs to compensate for the missing source
Utils_Shell_StatusTypeDef Utils_Shell_Cmd_Echo(char* args) { return UTILS_SHELL_CONTINUE; }
Utils_Shell_StatusTypeDef Utils_Shell_Cmd_Clear(char* args) { return UTILS_SHELL_CONTINUE; }
Utils_Shell_StatusTypeDef Utils_Shell_Cmd_Reboot(char* args) { return UTILS_SHELL_EXIT; }

void setUp(void) {
  SPY_UART_Clear();
  input_idx = 0;
  SPY_Screen_Clear();
}

void tearDown(void) {}

void test_Lab_UART_Cmd_GetUsers_should_list(void) {
  Lab_UART_Cmd_GetUsers(NULL);

  TEST_ASSERT_NOT_NULL(strstr(SPY_UART_Buffer, "root"));
  TEST_ASSERT_NOT_NULL(strstr(SPY_UART_Buffer, "monitoring_svc"));
}

void test_Lab_UART_Cmd_Login_should_succeed(void) {
  SPY_UART_SetInput("monitoring_svc", "u4rt_1s_pr3tty_v3rb0s3");

  Utils_Shell_StatusTypeDef result = Lab_UART_Cmd_Login(NULL);

  TEST_ASSERT_EQUAL(UTILS_SHELL_EXIT, result);
  TEST_ASSERT_NOT_NULL(strstr(SPY_UART_Buffer, "Logged in successfully"));
  TEST_ASSERT_EQUAL(SPY_Screen_AccessDenied_Calls, 0);
}

void test_Lab_UART_Cmd_Login_should_fail(void) {
  SPY_UART_SetInput("monitoring_svc", "wr0ng_p4ss");

  Utils_Shell_StatusTypeDef result = Lab_UART_Cmd_Login(NULL);

  TEST_ASSERT_EQUAL(UTILS_SHELL_CONTINUE, result);
  TEST_ASSERT_NOT_NULL(strstr(SPY_UART_Buffer, "Incorrect password"));
  TEST_ASSERT_EQUAL(SPY_Screen_AccessDenied_Calls, 1);
  TEST_ASSERT_EQUAL(SPY_Screen_Anonymous_Calls, 1);
}

void test_Lab_UART_Cmd_UserDb_should_dump(void) {
  Lab_UART_Cmd_UserDb("--dump");

  TEST_ASSERT_NOT_NULL(strstr(SPY_UART_Buffer, "root"));
  TEST_ASSERT_NOT_NULL(strstr(SPY_UART_Buffer, "Password Hash"));
}

void test_Lab_UART_Cmd_Root_should_succeed(void) {
  SPY_UART_SetInput("linkinpark", NULL); 

  Utils_Shell_StatusTypeDef result = Lab_UART_Cmd_Root(NULL);

  TEST_ASSERT_EQUAL(UTILS_SHELL_EXIT, result);
  TEST_ASSERT_NOT_NULL(strstr(SPY_UART_Buffer, "Root authorization granted"));
  TEST_ASSERT_EQUAL(SPY_Screen_AccessDenied_Calls, 0);
}

void test_Lab_UART_Cmd_Root_should_fail(void) {
  SPY_UART_SetInput("wr0ng_p4ss", NULL);

  Utils_Shell_StatusTypeDef result = Lab_UART_Cmd_Root(NULL);

  TEST_ASSERT_EQUAL(UTILS_SHELL_CONTINUE, result);
  TEST_ASSERT_NOT_NULL(strstr(SPY_UART_Buffer, "Incorrect password"));
  TEST_ASSERT_EQUAL(SPY_Screen_AccessDenied_Calls, 1);
  TEST_ASSERT_EQUAL(SPY_Screen_User_Calls, 1);
}

int main(void) {
  UNITY_BEGIN();

  RUN_TEST(test_Lab_UART_Cmd_GetUsers_should_list);
  RUN_TEST(test_Lab_UART_Cmd_Login_should_succeed);
  RUN_TEST(test_Lab_UART_Cmd_Login_should_fail);
  RUN_TEST(test_Lab_UART_Cmd_UserDb_should_dump);
  RUN_TEST(test_Lab_UART_Cmd_Root_should_succeed);
  RUN_TEST(test_Lab_UART_Cmd_Root_should_fail);

  return UNITY_END();
}
