Sleeeee/dvh/firmware/dvh/shared/include/utils_screen.h

#ifndef UTILS_SCREEN_H
#define UTILS_SCREEN_H

typedef enum {
  UTILS_SCREEN_STANDARD = 0,
  UTILS_SCREEN_HIGHLIGHT,
  UTILS_SCREEN_WARNING,
} Utils_Screen_State;

void Utils_Screen_Fill(Utils_Screen_State state);

void Utils_Screen_WriteChar(char c, Utils_Screen_State state);

void Utils_Screen_Write(char* text, Utils_Screen_State state);

void Utils_Screen_Fill_Write(char* text, Utils_Screen_State state);

void Utils_Screen_Welcome(void);

void Utils_Screen_Display_Lab(int lab_id);

void Utils_Screen_Lab_Not_Found(void);

void Utils_Screen_Lab_Reset(void);

void Utils_Screen_Lab_Reset_Failed(void);

void Utils_Screen_Lab_Init_Failed(void);

void Utils_Screen_Lab_Loaded(void);

void Utils_Screen_UART_Anonymous(void);

void Utils_Screen_UART_User(void);

void Utils_Screen_UART_Root(void);

void Utils_Screen_Access_Denied(void);

#endif
