Sleeeee/dvh/firmware/dvh/manager/src/lab_blink.c

#include "lab_blink.h"
#include "main.h"

void LabBlink_Selected(uint8_t count) {
  for (int i = 0; i < count; i++) {
    HAL_GPIO_WritePin(DOOR_OUT_GPIO_Port, DOOR_OUT_Pin, GPIO_PIN_SET);
    HAL_Delay(200);
    HAL_GPIO_WritePin(DOOR_OUT_GPIO_Port, DOOR_OUT_Pin, GPIO_PIN_RESET);
    HAL_Delay(200);
  }
}

void LabBlink_Broken(void) {
  HAL_GPIO_WritePin(DOOR_OUT_GPIO_Port, DOOR_OUT_Pin, GPIO_PIN_SET);
  HAL_Delay(1000);
}

void LabBlink_Reset(void) {
  HAL_GPIO_WritePin(DOOR_OUT_GPIO_Port, DOOR_OUT_Pin, GPIO_PIN_SET);
  HAL_Delay(1000);
  HAL_GPIO_WritePin(DOOR_OUT_GPIO_Port, DOOR_OUT_Pin, GPIO_PIN_RESET);
}

void LabBlink_Continue(void) {
  for (int i = 0; i < 3; i++) {
    HAL_GPIO_WritePin(DOOR_OUT_GPIO_Port, DOOR_OUT_Pin, GPIO_PIN_SET);
    HAL_Delay(50);
    HAL_GPIO_WritePin(DOOR_OUT_GPIO_Port, DOOR_OUT_Pin, GPIO_PIN_RESET);
    HAL_Delay(50);
  }
}
