Sleeeee/dvh/(commit log)

2025-11-27 DVH #6 Publish version 0.1 schematics
    [dvh.kicad_pcb, dvh.kicad_sch]
2025-12-23 DVH #1 Remove the deprecated Pico toolchain
2025-12-23 DVH #6 Rename the pcb/ directory to hardware/ for improved consistency
    [dvh.kicad_pcb, dvh.kicad_sch]
2025-12-23 DVH #9 Implement STM32 CMake toolchain (raw STM32CubeMX output)
2025-12-23 DVH #9 Add test code to blink LED
2025-12-25 DVH #9 Add complete documentation for setting up the Debugprobe and flashing the DVH board
2026-02-21 DVH #11 Implement UART file structure, write hello world
2026-02-21 DVH #11 Implement basic UART shell behavior
2026-02-21 DVH #11 Refactor UART and shell helpers (mostly hardware decoupling), write unit tests for helpers and UART lab commands
2026-02-21 DVH #11 Tell user to ask for help in UART shell
2026-02-21 DVH #11 Add README, instructions and complete walkthrough for UART lab
2026-02-21 DVH #11 Add README, instructions and walkthrough for UART
2026-04-06 DVH #14 Improve internal lab structure to allow resetting, write boilerplate for I2C lab
    [ilab.h, lab_i2c.c, lab_registry.c, lab_uart.c]
2026-04-06 DVH #14 Implement lab reset sequence, small file structure refactoring
    [lab_blink.c, lab_bootstrap.c, lab_i2c.c, lab_registry.c]
2026-04-06 DVH #14 Implement M24C02-W I2C driver
2026-04-06 DVH #14 Add lab reset error status, implement I2C lab reset
    [ilab.h, lab_blink.c, lab_bootstrap.c, lab_i2c.c, lab_i2c_data.c, lab_i2c_data.h]
2026-04-06 DVH #14 Refactor shell, UART and secrets helpers for better lab separation of concerns
2026-04-06 DVH #14 Implement I2C lab design
2026-04-06 DVH #14 Add mocks for I2C unit testing, refactor general structure
2026-04-06 DVH #14 Add full comprehensive documentation for I2C lab
2026-04-12 DVH #24 Implement unit testing for I2C lab, refactor mock architecture, fix tiny typo
    [lab_i2c_commands.c, mock_hal.c, mock_utils_uart.c, test_lab_i2c_commands.c, test_lab_uart_commands.c]
2026-04-12 DVH #24 Add skeleton for Renode testing, not implemented yet (Renode I2C driver issues)
    [lab_i2c.c]
2026-05-03 DVH #19 Add Kicad project, schematic and board files
    [base.kicad_sch, connectivity.kicad_sch, dvh.kicad_pcb, dvh.kicad_sch, glitching.kicad_sch, v1.kicad_pcb, v1.kicad_sch]
2026-05-03 DVH #22 Migrate firmware to match v1 hardware architecture (regenerate from CubeMX, add software EEPROM WP control, change pin names, remove v0 workarounds)
    [firmware.ioc, lab_blink.c, lab_bootstrap.c, lab_i2c.c, lab_select.c, main.c]
2026-05-03 DVH #22 Adapt mock GPIO definitions to v1 board
2026-05-03 DVH #22 Migrade Renode tests to pcb v1
2026-05-19 DVH #25 Update CubeMX configuration (migrate SPI interface for ST7789 compatibility)
2026-05-19 DVH #25 #22 Fix critical CubeMX configuration (stabilizes ST7789 display)
    [firmware.ioc, main.c]
2026-05-19 DVH #25 Implement screen feedback on UART lab
2026-05-19 DVH #25 Implement screen feedback on I2C lab
2026-05-24 DVH #13 Configure ATTiny-facing SPI and UART to compatible speeds
2026-05-24 DVH #13 Add ISP driver and basic glitch lab structure, program ATTiny on lab reset, sanity check UART connectivity
    [lab_glitch.c, lab_registry.c, utils_isp.c, utils_isp.h]
2026-05-24 DVH #13 Implement glitchable loop as a lab PoC
    [lab_glitch.c, main.c, utils_screen.c, utils_screen.h]
2026-05-24 DVH #13 Increase glitching attack surface, plant flag one (on fast brownout) and flag two (on successful glitch)
    [lab_glitch.c, lab_glitch_data.c, lab_glitch_data.h, main.c]
2026-05-24 DVH #13 Add final adjustments to glitching UI/UX
    [lab_glitch.c, main.c]
2026-05-24 DVH #13 Implement glitch lab unit tests, refactor part of the helper mocks for compatibility
    [mock_st7789.c, mock_utils_screen.c, test_lab_glitch_commands.c, test_utils_secrets.c, test_utils_shell.c]
2026-05-24 DVH #14 Fix missing text in I2C instructions document
2026-05-24 DVH #13 Add voltage glitching lab documentation and assets (ATTiny firmware and Glitcher script)
    [glitcher.py]
2026-05-25 Fix regression in building/testing pipeline
    [mock_utils_uart.c]
2026-05-27 DVH #30 Pin workflow actions to verified SHA
2026-05-27 DVH #26 Add OpenSCAD model (first PCB case attempt)
    [base.kicad_sch, connectivity.kicad_sch, dvh.kicad_pcb, dvh.kicad_sch, glitching.kicad_sch, v1.kicad_pcb, v1.kicad_sch, v1.scad]
